minhkhoinguyen206-netizen/H743-Flight-Controller/docs/images/boards-bare-bag.jpg

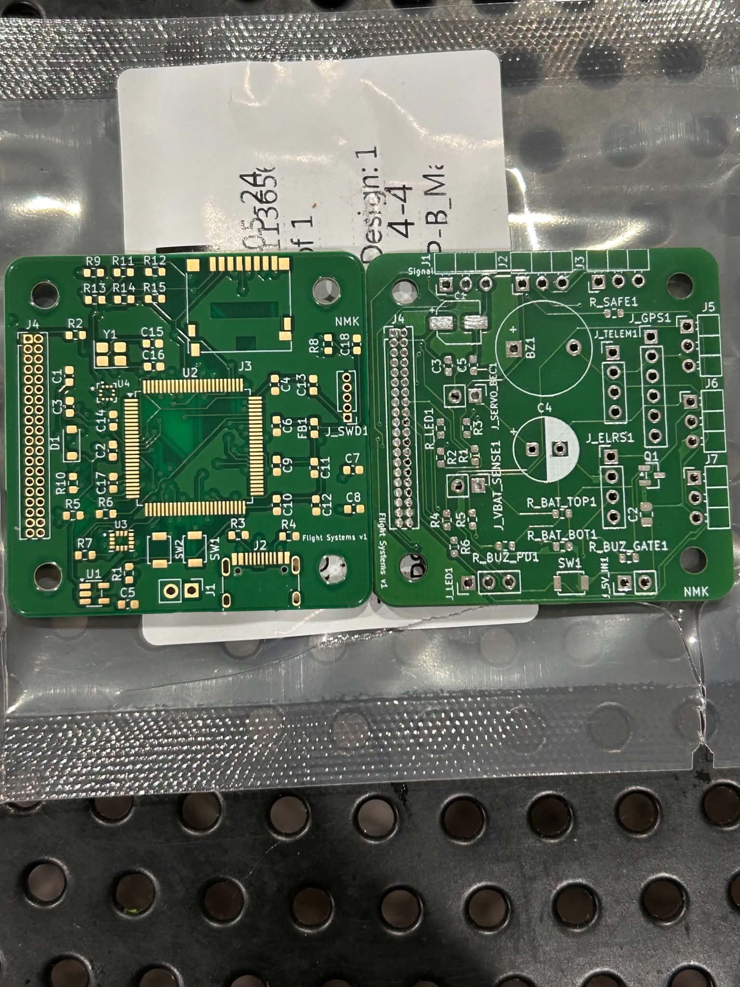
docs/images/boards-bare-bag.jpg
