minhkhoinguyen206-netizen/H743-Flight-Controller/docs/images/schematic-fc-top.png

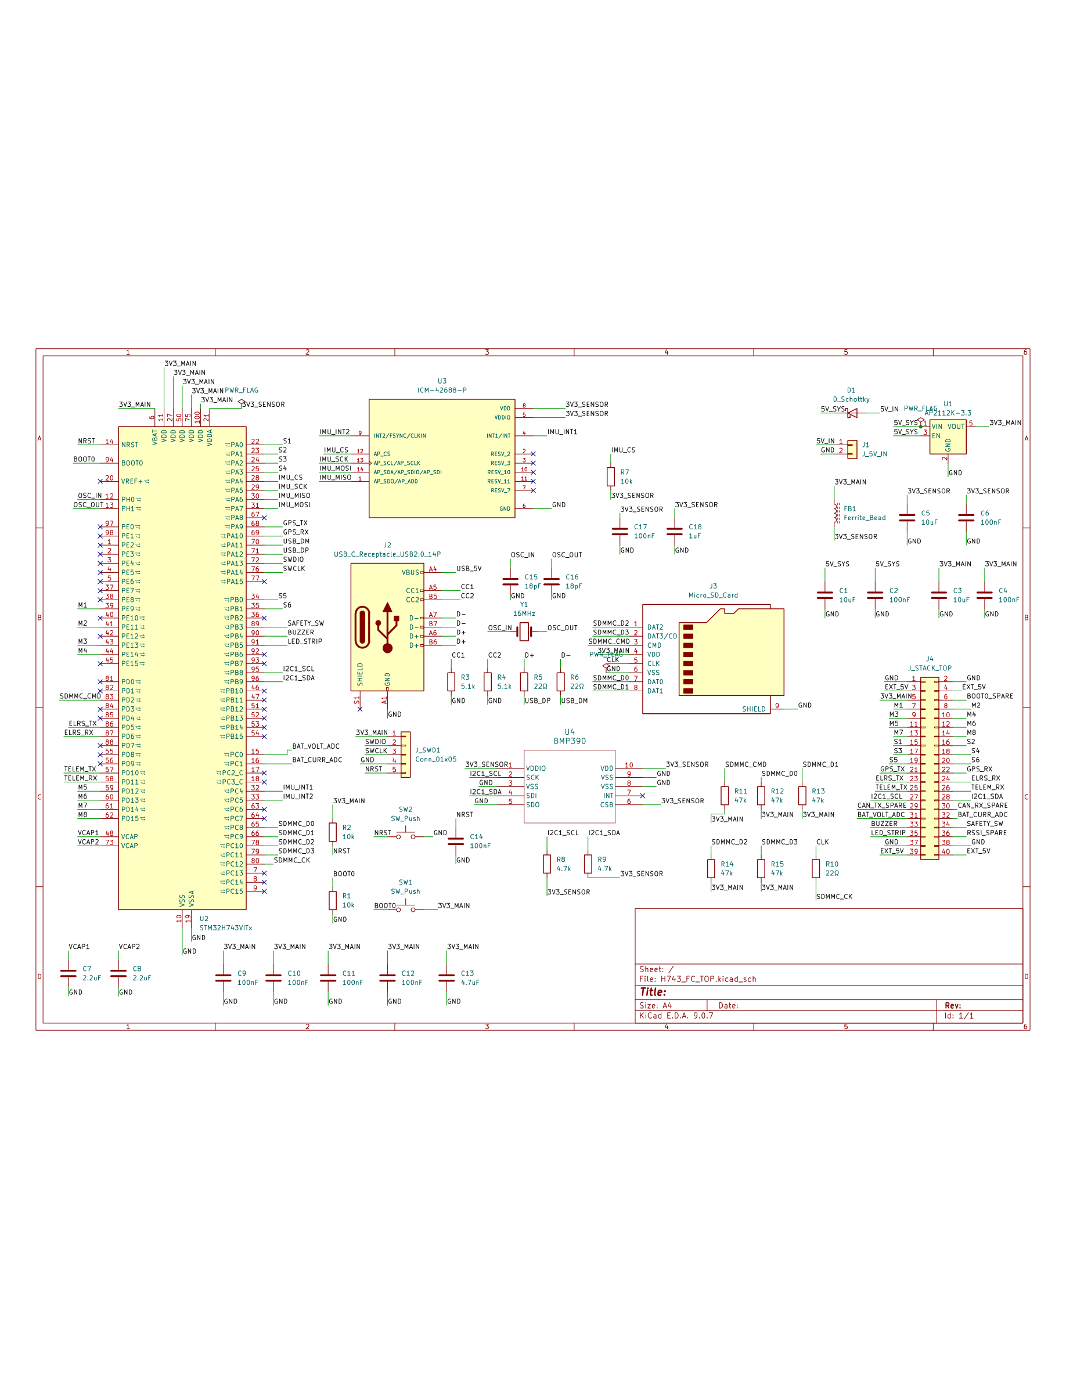
docs/images/schematic-fc-top.png
