minhkhoinguyen206-netizen/H743-Flight-Controller/docs/images/schematic-io-bottom.png

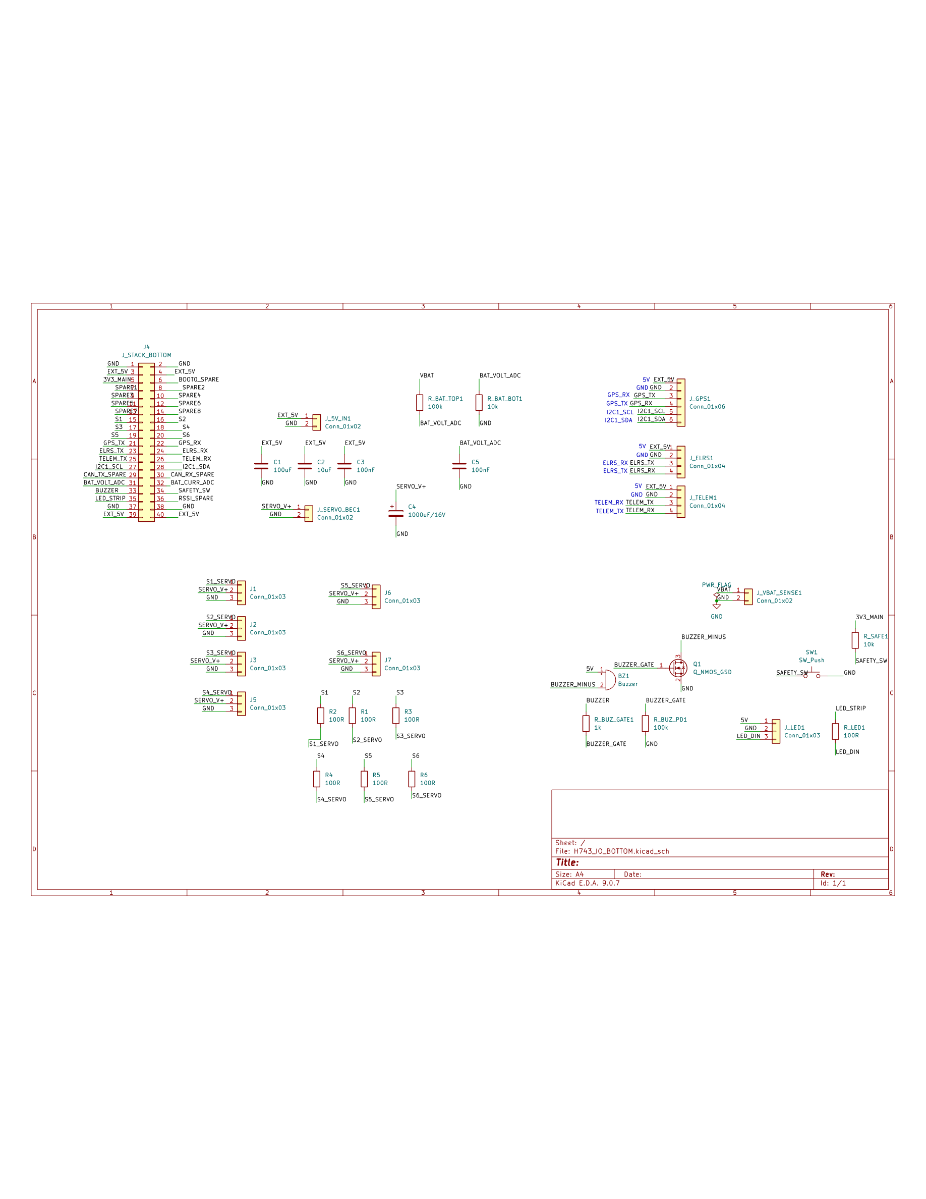
docs/images/schematic-io-bottom.png
